bricktrooper/Rainbow/README.md

# Rainbow

Rainbow is an RGB controller board for LED strips.  It can be controlled over UART serial interface using the provided Python library.

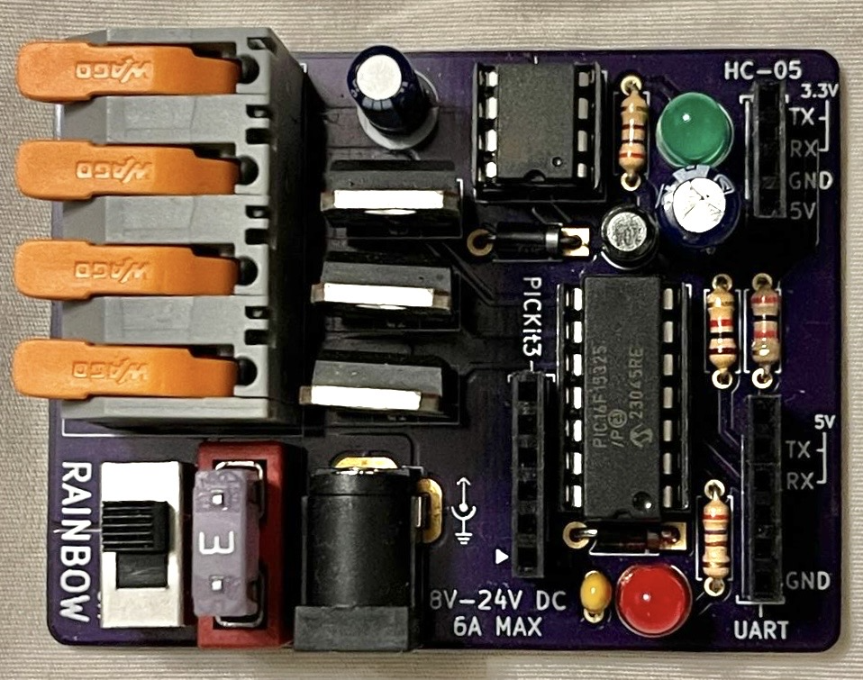
[picture p1: images/rainbow.png]
PCB


Demo
