bricktrooper/Rainbow/documentation/Automotive Fuse Form Factors.jpg

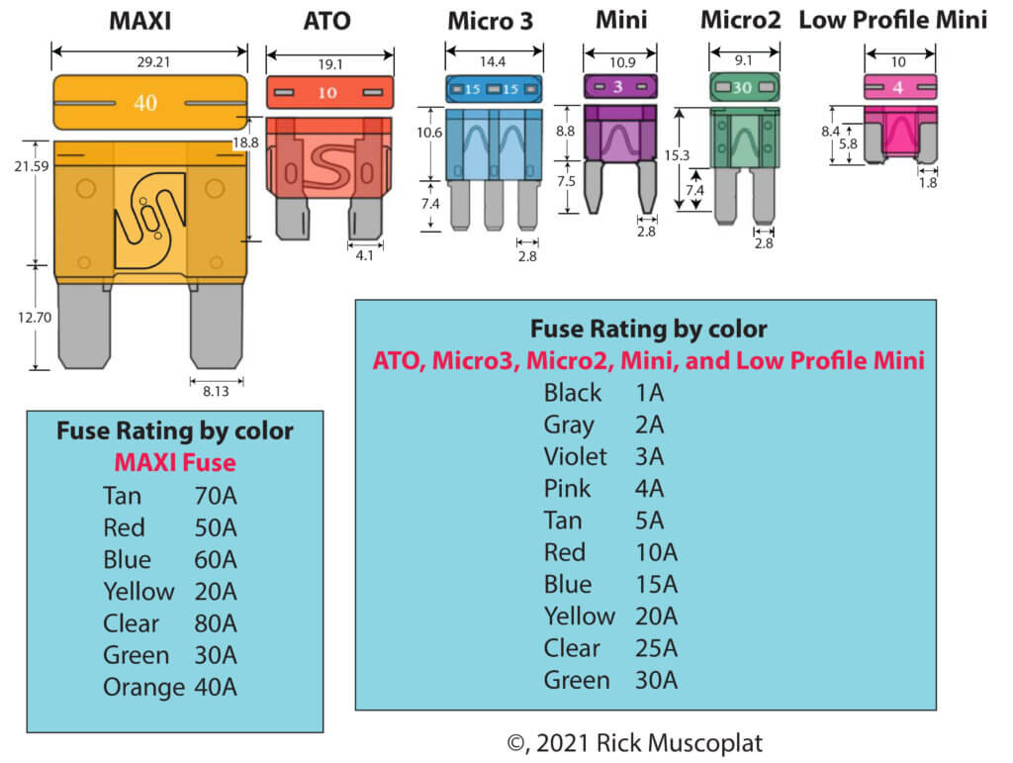
documentation/Automotive Fuse Form Factors.jpg
