bricktrooper/Rainbow/hardware/footprints/models/Wago.step

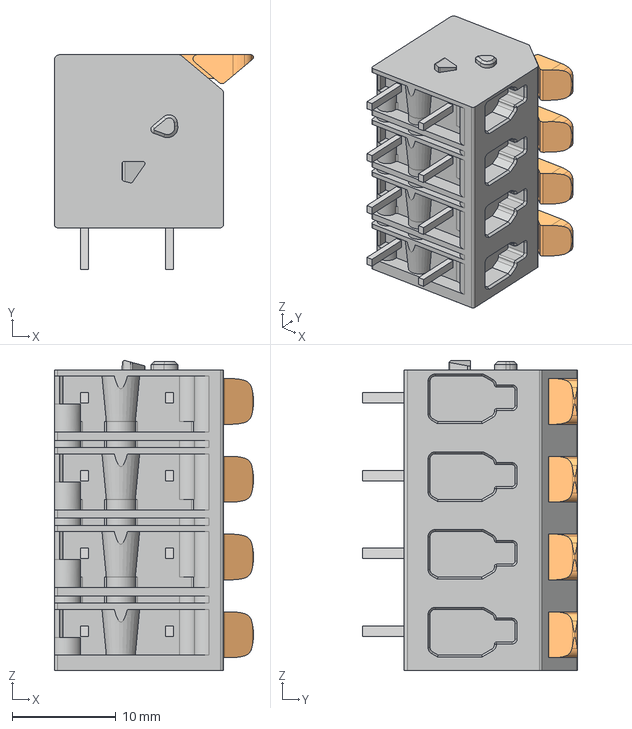
[picture p3: CAD file, 2023-05-19]
hardware/footprints/models/Wago.step
19.2 x 20.7 x 29.9 mm
