bricktrooper/Rainbow/hardware/footprints/models/Barrel_Jack.step

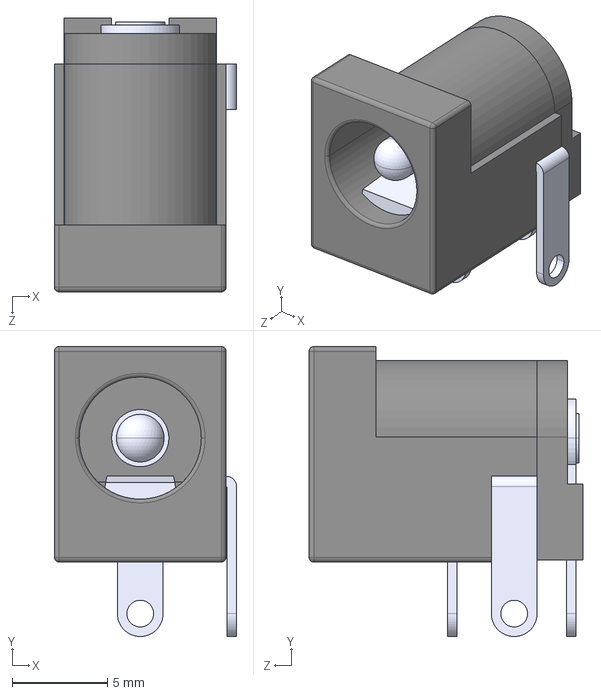
[picture p4: CAD file, 2023-01-02]
hardware/footprints/models/Barrel_Jack.step
9.55 x 15.2 x 14.4 mm
