bricktrooper/Rainbow/hardware/footprints/models/SPDT.step

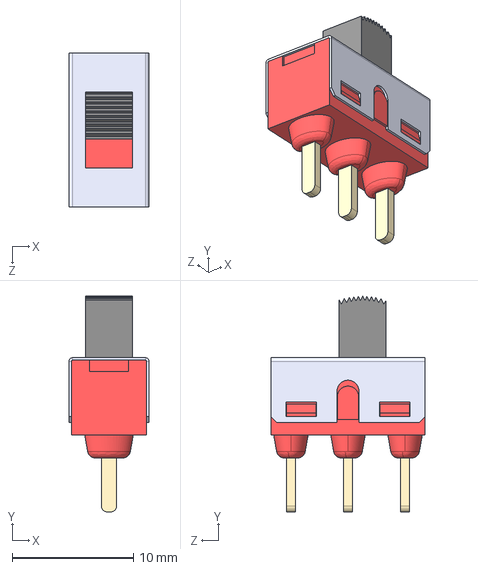
[picture p5: CAD file, 2022-12-29]
hardware/footprints/models/SPDT.step
6.60 x 17.8 x 12.7 mm
