bricktrooper/Rainbow/hardware/Rainbow.kicad_pcb

## KiCad design hardware/Rainbow.kicad_pcb (2023-07-08)

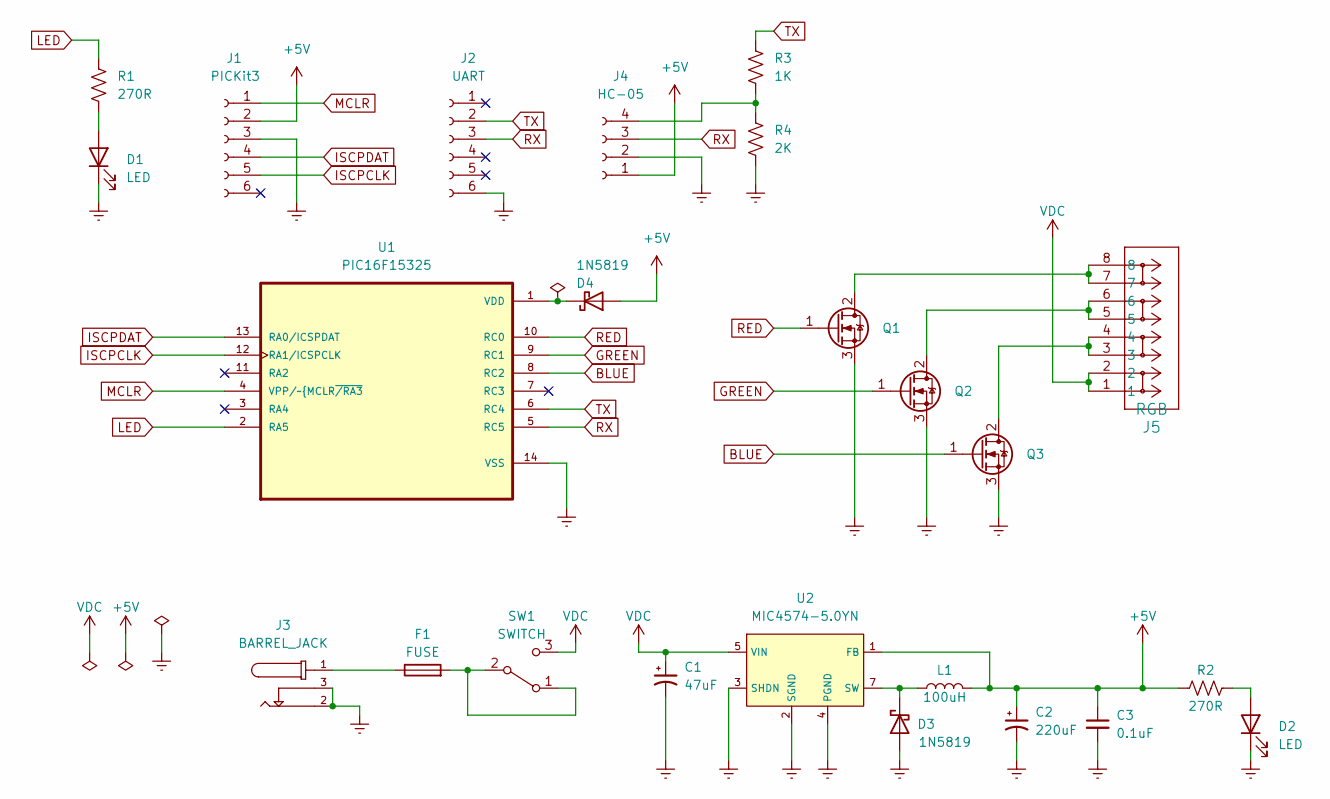
[picture p6: schematic Rainbow.kicad_sch]

Parts:
C1: 47uF; CP_Radial_D5.0mm_P2.50mm
C2: 220uF; CP_Radial_D6.3mm_P2.50mm
C3: 0.1uF; C_Disc_D3.0mm_W1.6mm_P2.50mm
D1, D2: LED; LED_D5.0mm
D3, D4: 1N5819; D_DO-41_SOD81_P7.62mm_Horizontal
F1: FUSE; Fuseholder_Blade_Mini_Keystone_3568
J1: PICKit3; PinSocket_1x06_P2.54mm_Vertical
J2: UART; PinSocket_1x06_P2.54mm_Vertical
J3: BARREL_JACK; Barrel_Jack; PARTREV A
J4: HC-05; PinSocket_1x04_P2.54mm_Vertical
J5: RGB; Wago
L1: 100uH; CP_Radial_Tantal_D4.5mm_P2.50mm
Q1, Q2, Q3: Q_NMOS_GDS; TO-220-3_Vertical
R1, R2: 270R; R_Axial_DIN0207_L6.3mm_D2.5mm_P7.62mm_Horizontal
R3: 1K; R_Axial_DIN0207_L6.3mm_D2.5mm_P7.62mm_Horizontal
R4: 2K; R_Axial_DIN0207_L6.3mm_D2.5mm_P7.62mm_Horizontal
SW1: SWITCH; CK_Switch
U1: PIC16F15325; DIP-14_W7.62mm_Socket_LongPads
U2: MIC4574-5.0YN; DIP-8_W7.62mm_Socket_LongPads

Connections:
+5V: C2.1, C3.1, D4.2 (A), J1.2, J4.1, L1.2, R2.1, U2.1 (FB)
BLUE: Q3.1 (G), U1.8 (RC2)
GNDREF: C1.2, C2.2, C3.2, D1.1 (K), D2.1 (K), D3.2 (A), J1.3, J2.6, J3.2, J3.3, J4.2, Q1.3 (S), Q2.3 (S), Q3.3 (S), R4.2, U1.14 (VSS), U2.2 (SGND), U2.3 (SHDN), U2.4 (PGND)
GREEN: Q2.1 (G), U1.9 (RC1)
ISCPCLK: J1.5, U1.12 (RA1/ICSPCLK)
ISCPDAT: J1.4, U1.13 (RA0/ICSPDAT)
LED: R1.1, U1.2 (RA5)
MCLR: J1.1, U1.4 (VPP/~MCLR~{/RA3)
unnamed: D1.2 (A), R1.2
unnamed: D2.2 (A), R2.2
unnamed: D3.1 (K), L1.1, U2.7 (SW)
unnamed: D4.1 (K), U1.1 (VDD)
unnamed: F1.1, J3.1
unnamed: F1.2, SW1.1 (A), SW1.2 (B)
unnamed: J4.4, R3.2, R4.1
unnamed: J5.3, J5.4, Q3.2 (D)
unnamed: J5.5, J5.6, Q2.2 (D)
unnamed: J5.7, J5.8, Q1.2 (D)
RED: Q1.1 (G), U1.10 (RC0)
RX: J2.3, J4.3, U1.5 (RC5)
TX: J2.2, R3.1, U1.6 (RC4)
VDC: C1.1, J5.1, J5.2, SW1.3 (C), U2.5 (VIN)

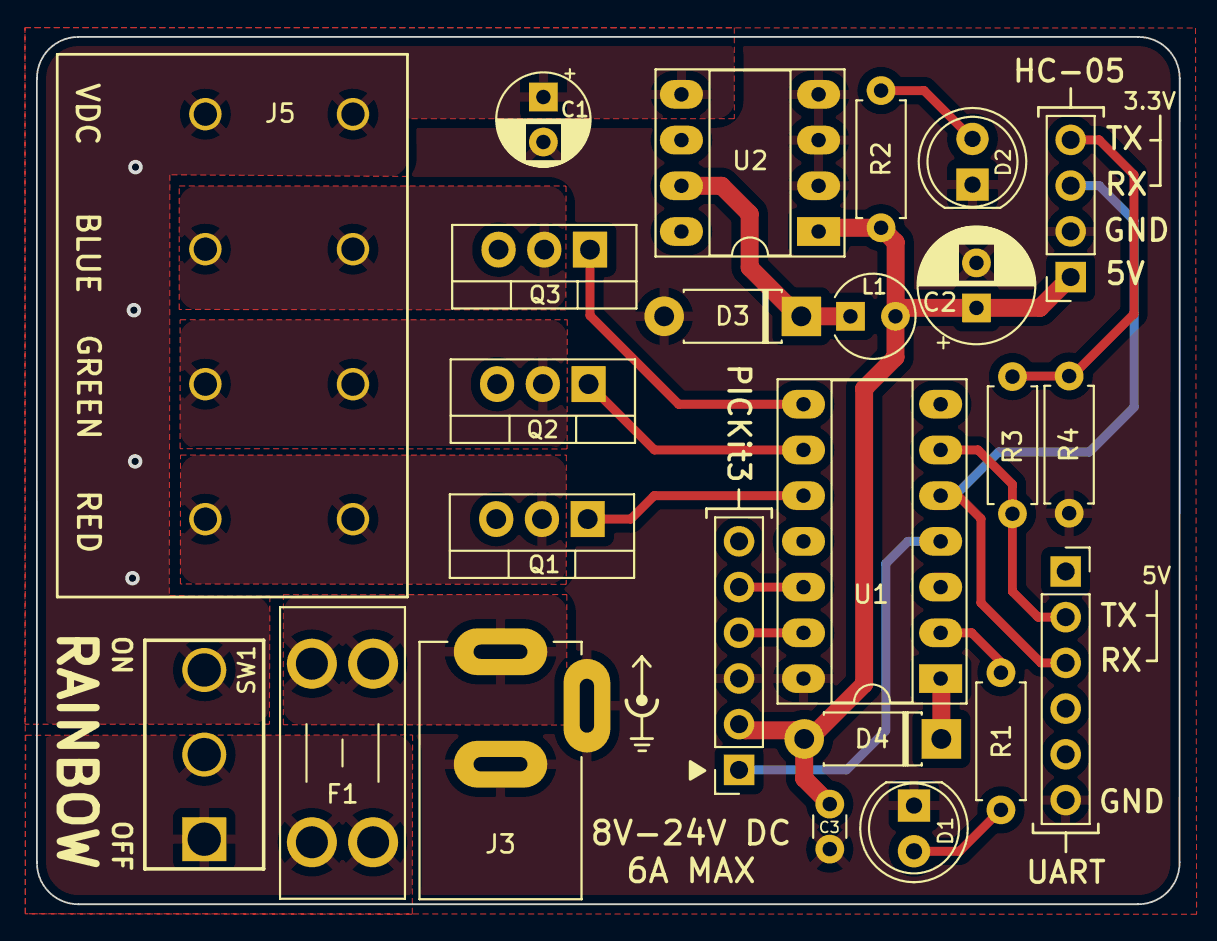
[picture p7: board Rainbow.kicad_pcb from above]

Board: 2 copper layers, 63.5 x 48.2 mm, 24 parts (0 on the bottom side), 22 nets.
