bricktrooper/Rainbow/firmware/application/system.h

#ifndef SYSTEM_H
#define SYSTEM_H

#define OUTPUT   0
#define INPUT    1

#define DIGITAL    0
#define ANALOGUE   1

#define ABORT(reason)   system_abort(reason, __func__)

#include "types.h"

typedef enum Abort Abort;

enum Abort
{
	ABORT_RX_OVERRUN,
	ABORT_RX_BUFFER_OVERFLOW,
	ABORT_TX_BUFFER_OVERFLOW,
	ABORT_PAYLOAD_OVERFLOW,
	ABORT_INVALID_BAUD_RATE,

	ABORT_count,
};

void system_initialize(void);                          // intialize microcontroller
void system_abort(Abort abort, char const * caller);   // abort program and enter error state
void system_reboot(void);                              // reboot microcontroller

#endif /* SYSTEM_H */
