bricktrooper/Rainbow/firmware/peripherals/oscillator.h

#ifndef OSCILLATOR_H
#define OSCILLATOR_H

#include "types.h"

typedef enum HFFRQ HFFRQ;

enum HFFRQ
{
	HFFRQ_RESERVED = 0b111,
	HFFRQ_32MHZ    = 0b110,
	HFFRQ_16MHZ    = 0b101,
	HFFRQ_12MHZ    = 0b100,
	HFFRQ_8MHZ     = 0b011,
	HFFRQ_4MHZ     = 0b010,
	HFFRQ_2MHZ     = 0b001,
	HFFRQ_1MHZ     = 0b000,
};

void oscillator_initialize(void);                 // initialize high-frequency internal oscillator
void oscillator_set_frequency(HFFRQ frequency);   // set oscillator frequency
U32 oscillator_get_frequency(void);               // get oscillator frequency

#endif /* OSCILLATOR_H */
