bricktrooper/Rainbow/(commit log)

2022-12-29 Generate KiCad project
    [Rainbow.kicad_pcb, Rainbow.kicad_sch]
2022-12-29 Preliminary schematic
    [Rainbow.kicad_sch]
2022-12-29 Schematic tweaks and untangle PCB ratsnest
    [CK_Switch.step, Rainbow.kicad_pcb, Rainbow.kicad_sch]
2022-12-29 Add capacitors to power supply
    [Rainbow.kicad_pcb, Rainbow.kicad_sch]
2022-12-31 A bunch of stuff
    [Rainbow.kicad_pcb, Rainbow.kicad_sch]
2023-01-02 Finish PCB
    [CK_Switch.step, Rainbow.kicad_pcb, Rainbow.kicad_sch, Tensility_Barrel_Jack.step]
2023-01-02 Finish up board
    [Rainbow.kicad_pcb]
2023-01-04 tweak silk and placement
    [Rainbow.kicad_pcb, Rainbow.kicad_sch]
2023-01-05 Fix FET pins and traces
    [Rainbow.kicad_pcb, Rainbow.kicad_sch]
2023-01-30 Folder renaming
    [CK_Switch.step, Rainbow.kicad_pcb, Rainbow.kicad_sch, Tensility_Barrel_Jack.step]
2023-01-30 LED working
2023-02-06 WIP UART
2023-02-21 Fix clock switching
2023-03-07 PWM working
2023-03-21 Add fuse
    [Rainbow.kicad_pcb, Rainbow.kicad_sch]
2023-03-21 Bottom 5V polygons
    [Rainbow.kicad_pcb]
2023-03-22 Finish up PCB
    [Rainbow.kicad_pcb]
2023-03-27 Notes for hardware rework
    [Rainbow.kicad_pcb, Rainbow.kicad_sch]
2023-03-29 Fix PWM duty cycle bugs
    [pwm.c, pwm.h]
2023-03-29 PWM4 and PWM5
2023-05-19 Re-engineer board for flexible power supply
    [Barrel_Jack.step, Rainbow.kicad_pcb, SPDT.step, Wago.step]
2023-05-19 Finish wiring
    [Rainbow.kicad_pcb, Rainbow.kicad_sch]
2023-05-20 Clean up some PCB stuff
    [Rainbow.kicad_pcb]
2023-05-20 0.1 uF bypass capacitor
    [Rainbow.kicad_pcb, Rainbow.kicad_sch]
2023-05-27 Change diode footprint
    [Rainbow.kicad_pcb, Rainbow.kicad_sch]
2023-05-27 Fix warnings and UART echo
    [link.c, link.h, uart.c, uart.h]
2023-05-30 Diodes for reverse polarity protection
    [Rainbow.kicad_pcb, Rainbow.kicad_sch]
2023-05-30 Remove extra diode on RX line
    [Rainbow.kicad_pcb, Rainbow.kicad_sch]
2023-05-31 Generate gerbers
    [Rainbow-B_Cu.gbr, Rainbow-B_Mask.gbr, Rainbow-B_Silkscreen.gbr, Rainbow-Edge_Cuts.gbr, Rainbow-F_Cu.gbr, Rainbow-F_Mask.gbr, Rainbow-F_Silkscreen.gbr, Rainbow.drl]
2023-07-08 Swap footprints for C1 and C2
    [Rainbow.kicad_pcb, Rainbow.kicad_sch]
2023-07-08 Blink LED slower on startup
2023-07-08 Interrupts API
2023-07-08 Fatal UART on NULL pointer or overrun
2023-07-12 Move PWM frequency beyond audible range
    The PWM frequency causes coil while in the power supply.
    Change the prescaler to increase the frequency beyond the
    audible range.
2023-07-13 timer2 API
2023-07-13 Switch everything to 32 MHz
2023-07-14 Enable peripheral interrupts
2023-07-14 Async UART RX
2023-07-14 Async UART TX
2023-07-15 Make printf work with non-blocking mode
2023-07-15 Fix magic RX bug
    [link.c, link.h]
2023-07-16 Clean up timer2
2023-07-16 Timer0 API
2023-07-18 Increase TX buffer for printing
2023-07-18 Timer2 interrupt enable function
2023-07-18 Add count parameter to led blink function
2023-07-18 Start with interrupts masked
2023-07-18 Timer2 clock source enums
2023-07-18 Remove timer0 interrupt for rainbow
    Interrupt starves UART interrupts so switch
    rainbow to poll for timer0 expiration instead.
    This adds overhead for updating the rainbow
    even when it is not active. Also repeated pings
    are not 100 % smooth but at least it seems to
    be stable (I hope).
2023-07-18 UART debug and warning messages
2023-07-18 Encapsulate UART non-blocking and blocking modes
2023-07-18 Renaming of UART interrupt APIs
2023-07-20 Fix ping printing
2023-07-20 Fix cycle disable bug with timer flag
    [rainbow.c, rgb.c, rgb.h, timer0.c, timer0.h]
2023-07-25 Remove UART purge functions
2023-07-25 Fix baud rate bug in HC-05 script
    [hc05.c]
2023-07-26 Reduce UART timeout
