bricktrooper/Rainbow/(notices)

Notices in the files:
hardware/footprints/models/Wago.step:
author */ ('License CC BY-ND 4.0'),
